WillScottJackson/DarkglassMidiFootswitch/Photos/20201001_225645.jpg

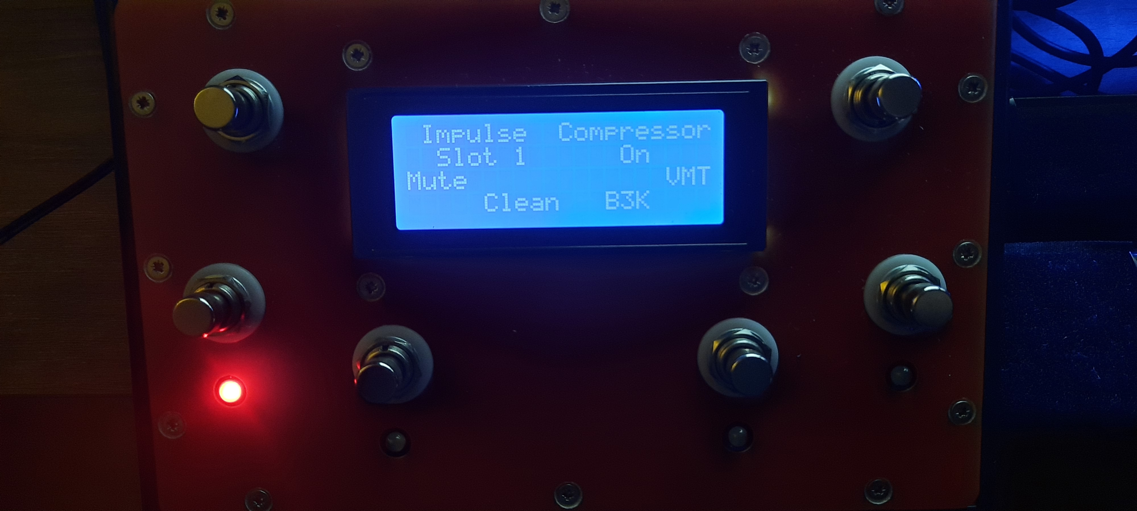
Photos/20201001_225645.jpg
