WillScottJackson/DarkglassMidiFootswitch/Footswitch Enclosure.pdf

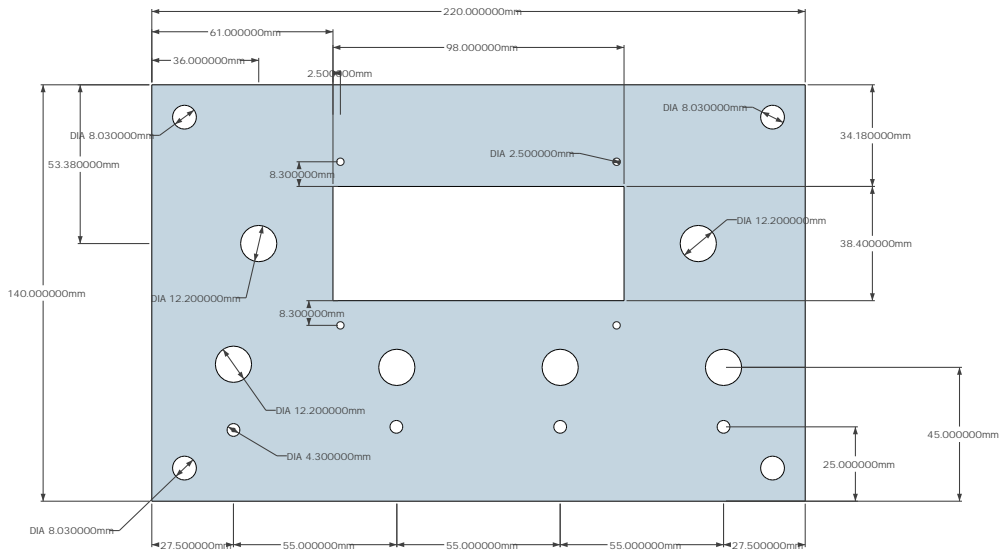
[picture p11: page 1]
DIA 8.030000mm; DIA 12.200000mm; DIA 2.500000mm; DIA 4.300000mm
