WillScottJackson/DarkglassMidiFootswitch/MIDI-Switch_schem.pdf

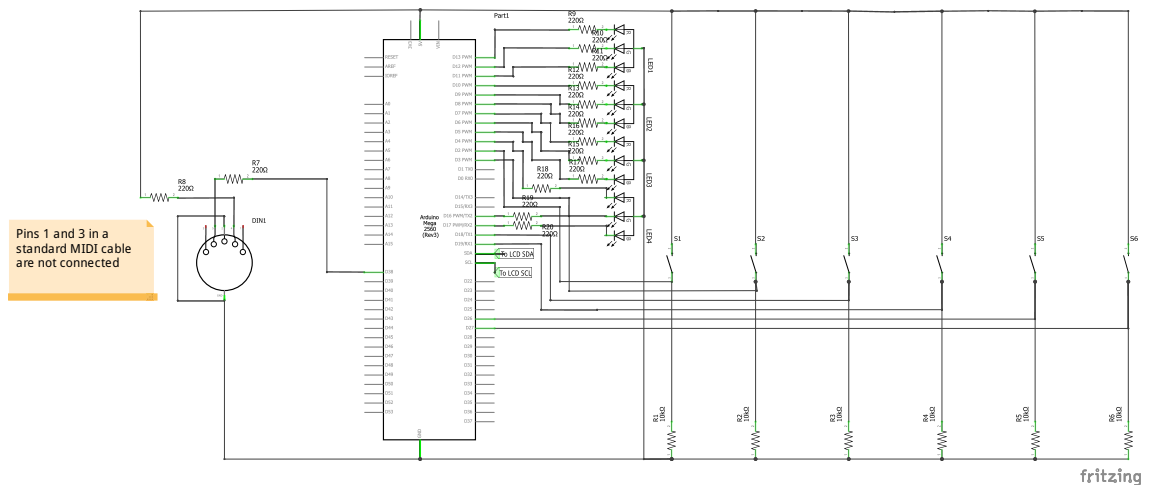
[picture p12: page 1]

Pins 1 and 3 in a
standard MIDI cable
are not connected
