WillScottJackson/DarkglassMidiFootswitch/MIDI Footswitch Controller/SparkBluetoothDefs.h

#pragma once

const char sparkBluetoothName[] = "Spark 40 Audio";

const int loadTonePresetCmdSize = 27;

byte cmdLoadTonePreset1[] = 
{
  0x01, 0xFE, 0x00, 0x00,
  0x53, 0xFE, 0x1A, 0x00,
  0x00, 0x00, 0x00, 0x00,
  0x00, 0x00, 0x00, 0x00,
  0xF0, 0x01, 0x24, 0x00,
  0x01, 0x38, 0x00, 0x00,
  0x00, 0xF7
};

byte cmdLoadTonePreset2[] = {
  0x01, 0xFE, 0x00, 0x00,
  0x53, 0xFE, 0x1A, 0x00,
  0x00, 0x00, 0x00, 0x00,
  0x00, 0x00, 0x00, 0x00,
  0xF0, 0x01, 0x24, 0x00,
  0x01, 0x38, 0x00, 0x00,
  0x01, 0xF7
};

byte cmdLoadTonePreset3[] = {
  0x01, 0xFE, 0x00, 0x00,
  0x53, 0xFE, 0x1A, 0x00,
  0x00, 0x00, 0x00, 0x00,
  0x00, 0x00, 0x00, 0x00,
  0xF0, 0x01, 0x24, 0x00,
  0x01, 0x38, 0x00, 0x00,
  0x02, 0xF7
};

byte cmdLoadTonePreset4[] = {
  0x01, 0xFE, 0x00, 0x00,
  0x53, 0xFE, 0x1A, 0x00,
  0x00, 0x00, 0x00, 0x00,
  0x00, 0x00, 0x00, 0x00,
  0xF0, 0x01, 0x24, 0x00,
  0x01, 0x38, 0x00, 0x00,
  0x03, 0xF7
};

byte* cmdLoadTonePresetList[] = {
  cmdLoadTonePreset1,
  cmdLoadTonePreset2,
  cmdLoadTonePreset3,
  cmdLoadTonePreset4
};
